juandoval/nose-gear/NoseGear_V3.stp

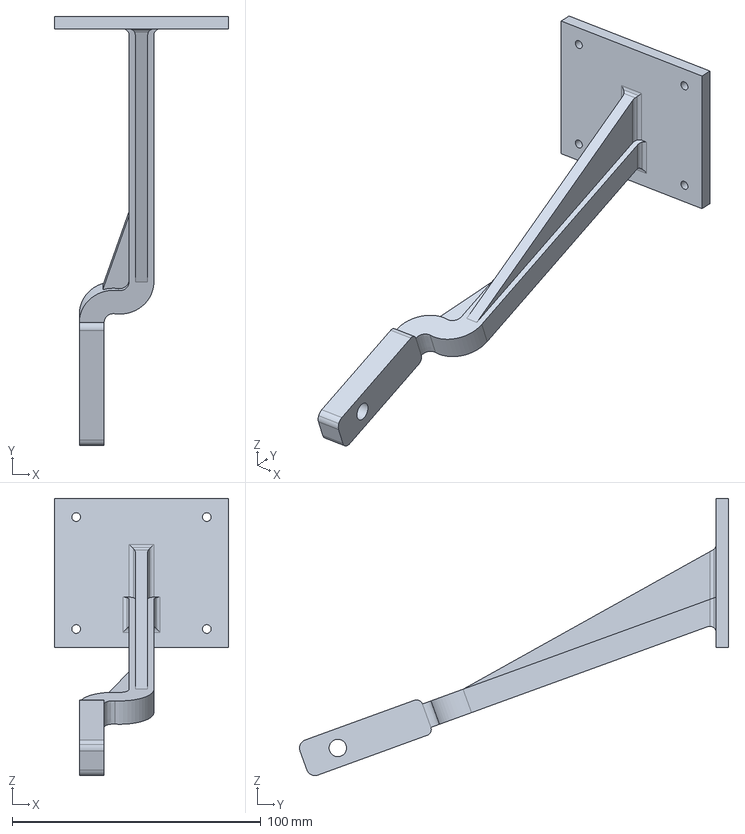
[picture p13: CAD file, 2026-02-09]
NoseGear_V3.stp
70.0 x 172.5 x 111.4 mm
NoseGear
