juandoval/nose-gear/NoseGear_V2.step

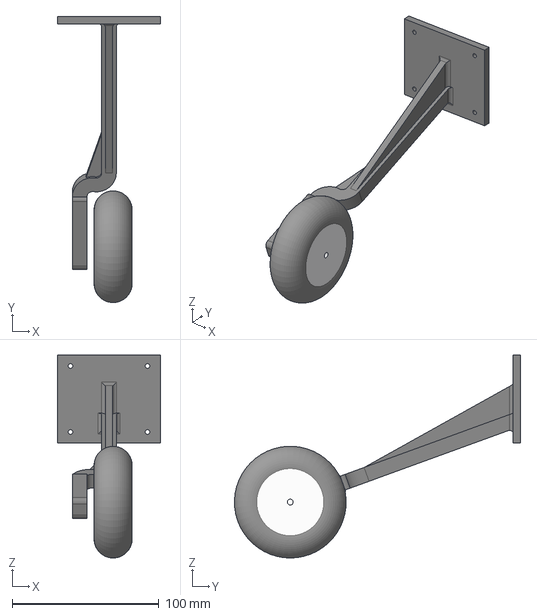
[picture p14: CAD file, 2026-02-03]
NoseGear_V2.step
70.0 x 195.1 x 138.4 mm
