juandoval/nose-gear/(list of files, cad)

Other CAD files:
NoseGear_Revised.stp
NoseGear_V3.stl
